dosferatu/electronic-compass/Documentation/Project Documentation/Weekly Status Reports/Cody/Cody Weekly Status Report 6.docx

Weekly Status Report

Electronic Compass Practicum Project

Team Member: Cody Gabriel

Week of 11/25/2013:

- Finished HW: Test Plan
- Created solder masks in EPL using laser cutter
- Bought backordered resistors from IEEE store on campus
- Unsuccessful search for needed physical switches
- Started presentation preparation outline

Next week:

- Continue search for switches; Surplus Gizmos?
- As parts come in, check them off the BOM
- Continuity check the boards
- Once all parts have come in, solder board together
