dosferatu/electronic-compass/Documentation/Project Documentation/Weekly Status Reports/Cody/Cody Weekly Status Report 7.docx

Weekly Status Report

Electronic Compass Practicum Project

Team Member: Cody Gabriel

Week of 12/2/2013:

- Found needed switches at Surplus Gizmos
- PMIC was not ordered; ordered with overnight shipping, arrived Friday
- Continuity check performed on all the boards
- One board was soldered together using reflow oven
- Discovered that μC needs preprogrammed to use USB

Next week:

- Program μC to use USB, then use USB to program
- Continue troubleshooting board
- Finish project presentation
- Continue revising documentation
- Present project on Fri, Dec. 13
