dosferatu/electronic-compass/Documentation/Project Documentation/Weekly Status Reports/Cody/Cody Weekly Status Report 4.docx

Weekly Status Report

Electronic Compass Practicum Project

Team Member: Cody Gabriel

Week of 11/11/2013:

- Finished write up for project schedule
- Revised and refined board layout with John
- Ensure board is ready to be sent to OSH Park, made changes advised by Andrew
- Fixed PMIC symbol with pins switched
- Added resistor to GPIO controlled switches
- Created system diagrams for System Design/Modeling, due 11/20/2013

For next week:

- Create BOM and order parts
- Finish System Design and Modeling due 11/20/2013
- Send board files to OSH Park by midnight 11/19/2013
- Look ahead to next week’s HW: Test Plan due 11/27/2013
- Find out what it takes to create a solder mask in EPL
