dosferatu/electronic-compass/Documentation/Project Documentation/Weekly Status Reports/Cody/Cody Weekly Status Report 5.docx

Weekly Status Report

Electronic Compass Practicum Project

Team Member: Cody Gabriel

Week of 11/18/2013:

- Created BOM and ordered parts
- Finished System Design and Modeling
- Sent board files to OSH Park on 11/19/2013
- Worked on this week’s HW: Test Plan due 11/27/2013

For next week:

- Finish HW: Test Plan
- Create solder masks in EPL using laser cutter
- Order switches and 2 resistor values in their respective quantities (backordered)
- Boards should be back soon, construct systems
- Proceed with testing and debugging
- Revise all documentation
- Start presentation preparation; Power Point, etc.
