dosferatu/electronic-compass/Documentation/Project Documentation/Weekly Status Reports/John/John Maseda Weekly Progress Report 11-12-2013.docx

Weekly Status Report

Electronic Compass Practicum Project

Team Member: John Maseda

Week of 11/12/2013:

1. Adopted changes to the schematic into new board layout.
2. Adjusted routing as necessary. (version 2)
3. Checked board layout with Andrew to make sure all was correct.
4. Adopted recommended changes to the schematic and rerouted the board.
5. Board layout and routing completed. (version 2.1)
