dosferatu/electronic-compass/Documentation/Project Documentation/Weekly Status Reports/John/John Maseda Weekly Progress Report 11-19-2013.docx

Weekly Status Report

Electronic Compass Practicum Project

Team Member: John Maseda

Week of 11/19/2013:

1. New information caused changes to sch.
2. Updated layout and routing – redid most of the board layout and routing. (Version 3.0)
3. Checked with Andrew before first deadline submission.
4. Updated sch, and layout with changes.
5. Sent in files to Andrew for final check.
6. Fixed critical errors listed updated layout and routing.
7. Sent files in to OSHpark for fabrication.
8. Purchased boards $19.85 for 4
9. Purchased boards at Andrews request at the same price.
