dosferatu/electronic-compass/Documentation/Project Documentation/Weekly Status Reports/Cody/Cody Weekly Status Report 3.docx

Weekly Status Report

Electronic Compass Practicum Project

Team Member: Cody Gabriel

Week of 11/4/2013:

- Revise schematic
- Make schematic checklist
- Fixed headers on schematic to reflect requirements of AVR
- Changed PMOS transistors to a much smaller version
- Added tests points to unused AVR pins and in the power supply
- Worked on project schedule, due on Wed., 11/13/2013
- Worked with John on board layout

For next week:

- Do write up for project schedule
- Revise and refine board layout with John
- Create BOM and order parts
- Ensure board is ready to be sent to OSH Park
- Look ahead to next HW: System Design/Modeling, due 11/20/2013
