dosferatu/electronic-compass/Documentation/Project Documentation/Weekly Status Reports/Ben/Weekly Status Report - 11 Nov.docx

Weekly Status Report

Electronic Compass Practicum Project

Team Member: Benjamin Huntsman

Week of 11/11/2013:

1. Started work on the image data structure to be used in the LCD
2. Worked on the schematic to make recommended changes from Andrew
3. Made updates to the board layout per schematic changes
4. Worked out LCD image algorithm for changing parts of the LCD instead of keeping a bunch of separate images.
