dosferatu/electronic-compass/Documentation/Project Documentation/Weekly Status Reports/Ben/Weekly Status Report - 4 Nov.docx

Weekly Status Report

Electronic Compass Practicum Project

Team Member: Benjamin Huntsman

Week of 11/4/2013:

1. Finished verification of SPI layout on board for the LCD.
2. Researched SPI programming
3. Uploaded necessary updates to group about pin layout for MCU and peripherals
4. Worked on algorithm for LCD screen mapping
