dosferatu/electronic-compass/Documentation/Project Documentation/Weekly Status Reports/John/John Maseda Weekly Progress Report 11-05-2013.docx

Weekly Status Report

Electronic Compass Practicum Project

Team Member: John Maseda

Week of 11/05/2013:

1. Completed board layout and routing.
