dosferatu/electronic-compass/Documentation/Project Documentation/Weekly Status Reports/Michael/WSR 11-09-13.docx

Weekly Status Report

Michael Walton

11/09/13

Looked in to using USB for serial communication for debugging and found it to be more work than simply placing LEDs where I am outputting highs from the 32U4, so I decided to just stick to working on the program itself. Communication with the LSM303 sensor has been established; I set an LED to light up when a data ready is read from bit 0 of the status register in the LSM303 magnetometer. TWI interface is finished, and the LSM303 interface is almost finished for reading the sensor.
