dosferatu/electronic-compass/Documentation/Project Documentation/Weekly Status Reports/Cody/Cody Weekly Status Report 2.docx

Weekly Status Report

Electronic Compass Practicum Project

Team Member: Cody Gabriel

Week of 10/28/2013:

- For USB charging, a PMIC was suggested by Andrew
- Investigated PMIC’s, selected LTC4067
- Footprint and symbol for LTC4067 made in Eagle
- Schematic Draft 1 completed with PMIC, error and warning free

For next week:

- Revise schematic
- Make schematic checklist
- Finalize schematic to include aesthetics
- Work on project schedule, due date TBD
- Work with John on board layout once schematic is finalized
