dosferatu/electronic-compass/Documentation/Project Documentation/Weekly Status Reports/John/John Maseda Weekly Progress Report 10-22-2013.docx

Weekly Status Report

Electronic Compass Practicum Project

Team Member: John Maseda

Week of 10/22/2013:

1. Downloaded and installed necessary software for designing our device.
  a. Eagle CAD
  b. GitHub
2. Began reading project specific documentation relevant to generating the schematic.
  a. Used Eagle CAD to get familiarity with building a very basic schematic.
