dosferatu/electronic-compass/Documentation/Project Documentation/Weekly Status Reports/John/John Maseda Weekly Progress Report 10-29-2013.docx

Weekly Status Report

Electronic Compass Practicum Project

Team Member: John Maseda

Week of 10/29/2013:

1. Down-loaded the schematic for the ATmega32u4 from GitHub.
  a. Studied the schematic – will need the pinouts relevant to headders and signal names to begin adding to the base footprint and schematic of the ATmega 32u4.
  b. Began formatting and adding Schematic related items to the schematic file.
2. Added some last minute schematic editions to the work Cody performed.
  a. Added connecting traces from MPC to headers.
  b. Angled some Vcc points up and some GND points down.
  c. Shifted some wires to attempt some clarity.
3. Created the board layout file
  a. Began rough placement of componants.
