dosferatu/electronic-compass/Documentation/Project Documentation/Weekly Status Reports/Ben/Weekly Status Report - 28 Oct.docx

Weekly Status Report

Electronic Compass Practicum Project

Team Member: Benjamin Huntsman

Week of 10/28/2013:

1. Pin layout for LCD submitted to the group
2. Researched the SPI interface and available drivers for the MCU.
3. Figured out an appropriate layout for the board stacking so that the sensor is isolated.
