dosferatu/electronic-compass/Schematics/OSH DRU/Board_Layout_Checklist.xlsx

Item | On-Board
On/Off Switch | check
Headers wired | check
Transistor switching LCD LED | check
Transistor switching LCD Vcc | check
No pull-ups for I2C because it is on the breakout | check
Serial Resistors on USB Data lines must be 22 Ohms +/- 5% | check
All USB lines should be as close to the same length as possible
Ucap should be 1uF +/- 10% | check
A 10uF cap should be on VBUS line | check
Connect SPI SS pin (PB0) to LCD Vcc as the on/off pin | check
All TWI lines should be as close to the same length as possible
Any generic I/O pin can be used for LCD back light | check | used PB6
External Oscilloscope
Note: Without an external clock, the USB will have to configured to operate in low-speed mode with the internal RC oscillator as input source clock for the PLL (p.256). Setup for this is on p. 260.
