dosferatu/electronic-compass/Documentation/Project Documentation/Requirements.xlsx

Marketing Requirements | Engineering Requirements | Justification
4 | 1. The system should be accurate to within 5° of true orientation. | To be a viable compass for use it should have an accepatable accuracy that would not result in an individual or robot being lost at long distances.
1,2,5 | 2. The system should have a switch to power on the device and within a short time be ready for use. | To save battery life, the user should be able to turn the device on and off. The reinitialization of the device should require as little time as possible so that the user can get their heading and proceed with very little lost time.
1 | 3. The LCD display will show a heading (i.e. "N", "SW") and degrees from North between 0 and 360 degrees. | Without an actual moving compass face, the user will need to easily understand the output of the device. Having eight segments it will be easy for the user to visualize their bearing.
3 | 4. Should be prepared for later versioning in firmware that will give additional options and restore to factory default through a USB interface. | If an unforeseen software glitch were to arise the device will still possibly be useful if restored to factory settings. The device should be capable of a software update to correct any unforeseen glitches.
6 | 5. LCD screen will have a back light so that the compass can be used in light or dark. | Needs to be used in varying conditions.
Marketing Requirements
1. Should be easy to use
2. Should be portable
3. Should be capable of being restored to factory default settings and capable of software updates.
4. Should be accurate enough so that an individual would not be lost at long distances.
5. Reset/Calibration Functionality
6. Can be used in day/night
Project Name: | Electronic Compass
Member Names: | Cody Gabriel
 | John Maseda
 | Michael Walton
 | Ben Huntsman
Date: | 2013-10-22
Version: | 1
Wiki URL: | http://goo.gl/bQ3hTW
