dosferatu/electronic-compass/Documentation/Project Documentation/Project Schedule.docx

Project Schedule

T05 – Handheld Electronic Compass

Ben Huntsman

Michael Walton

Cody Gabriel

John Maseda

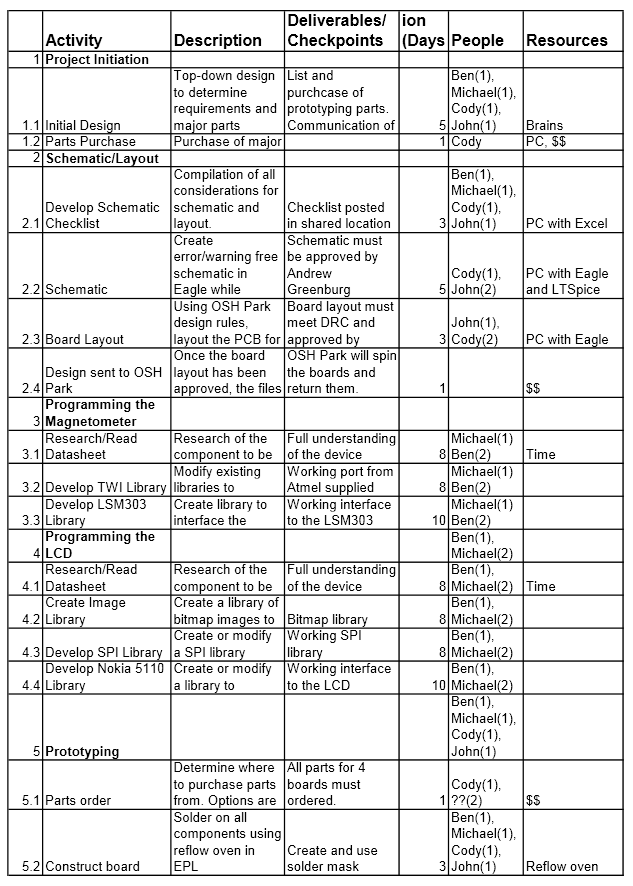
[picture p12: figure]
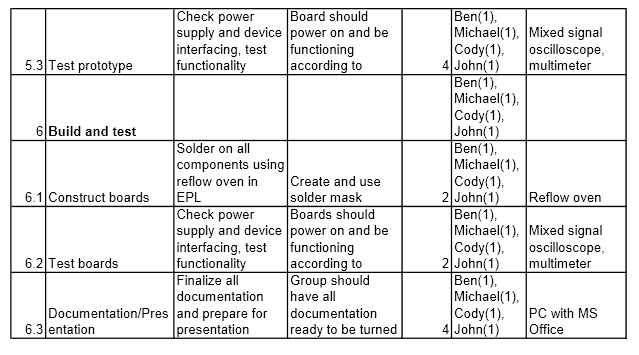
[picture p13: figure]
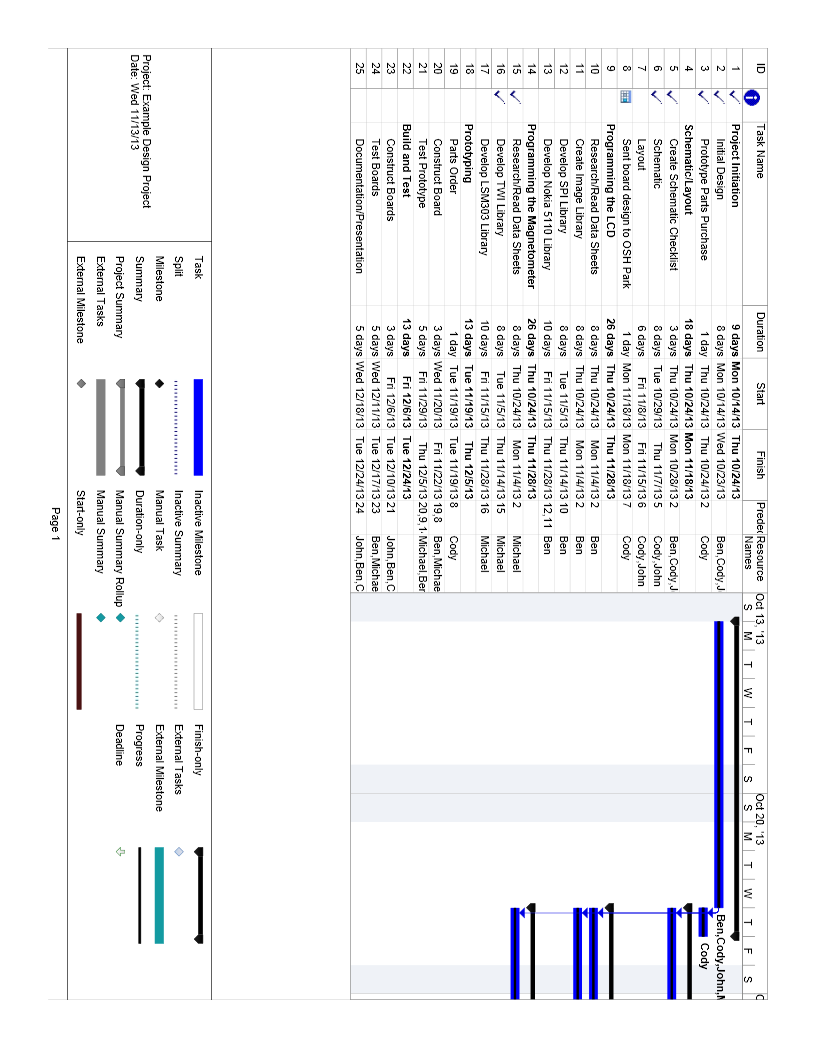
[picture p14: figure]
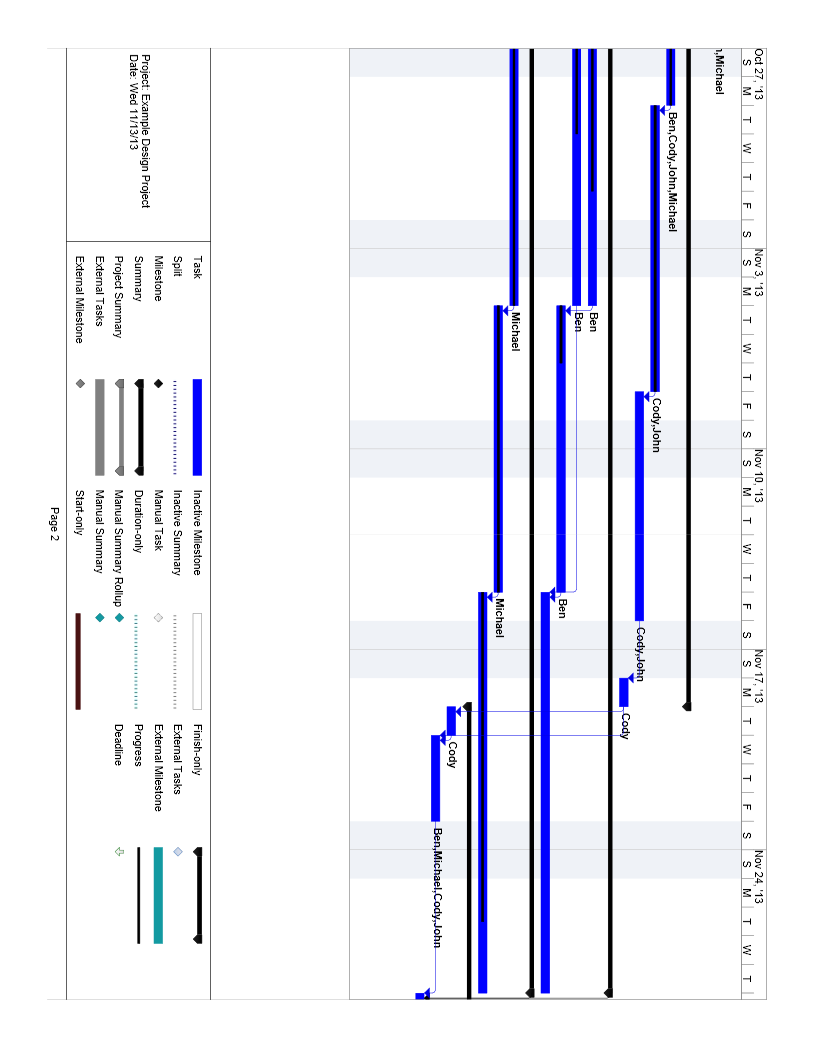
[picture p15: figure]
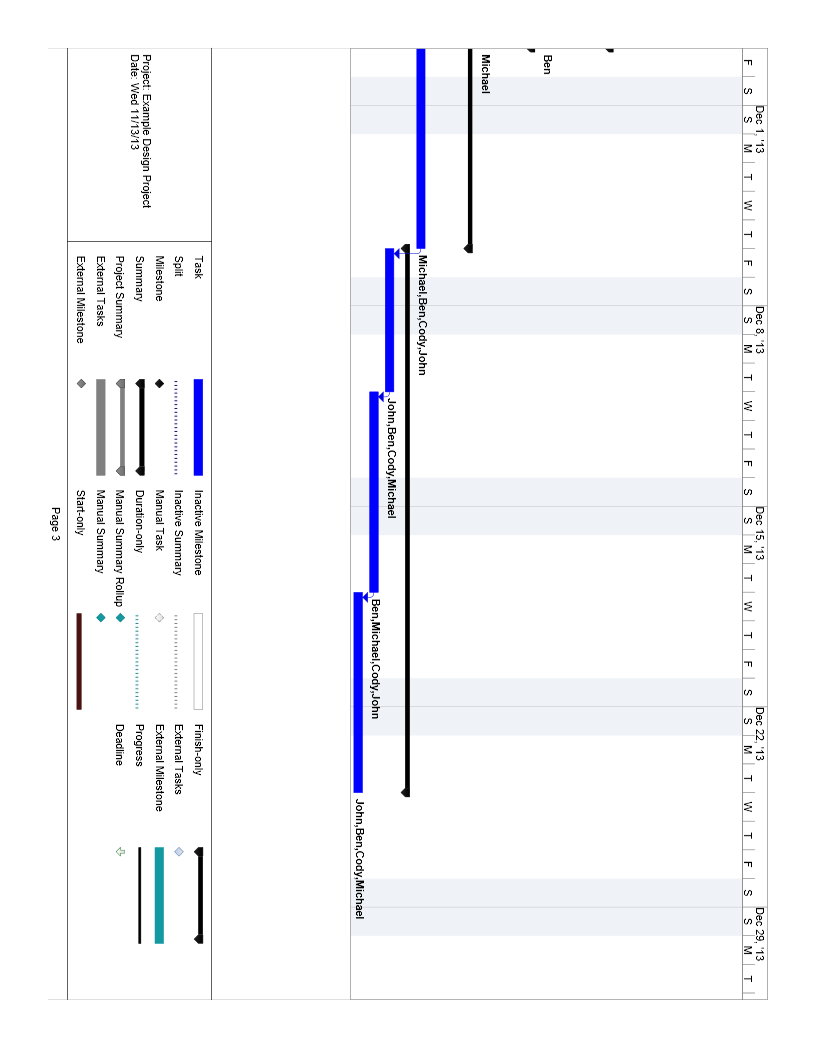
[picture p16: figure]
