dosferatu/electronic-compass/Documentation/Project Documentation/Work Breakdown Structure.xlsx

 | Activity | Description | Deliverables/Checkpoints | Duration (Days) | People | Resources | Predecessors
1 | Project Initiation
1.1 | Initial Design | Top-down design to determine requirements and major parts selection. | List and purchcase of prototyping parts. Communication of project goals | 5 | Ben(1), Michael(1), Cody(1), John(1) | Brains
1.2 | Parts Purchase | Purchase of major components. |  | 1 | Cody | PC, $$ | 1.1
2 | Schematic/Layout
2.1 | Develop Schematic Checklist | Compilation of all considerations for schematic and layout. | Checklist posted in shared location | 3 | Ben(1), Michael(1), Cody(1), John(1) | PC with Excel | 1.1
2.2 | Schematic | Create error/warning free schematic in Eagle while adhering to application notes for intercacing the major components. | Schematic must be approved by Andrew Greenburg | 5 | Cody(1), John(2) | PC with Eagle and LTSpice | 1.1
2.3 | Board Layout | Using OSH Park design rules, layout the PCB for the project based on the schematic. | Board layout must meet DRC and approved by Andrew Greenburg. | 3 | John(1), Cody(2) | PC with Eagle | 2.2
2.4 | Design sent to OSH Park | Once the board layout has been approved, the files will be sent to OSH Park. | OSH Park will spin the boards and return them. | 1 |  | $$ | 2.3
3 | Programming the Magnetometer
3.1 | Research/Read Datasheet | Research of the component to be able to proceed and program the device | Full understanding of the device operation | 8 | Michael(1) Ben(2) | Time | 1.2
3.2 | Develop TWI Library | Modify existing libraries to perform our specific requirements | Working port from Atmel supplied examples | 8 | Michael(1) Ben(2) |  | 3.1
3.3 | Develop LSM303 Library | Create library to interface the ATmega32u4 with the LSM303 | Working interface to the LSM303 | 10 | Michael(1) Ben(2) |  | 3.2
4 | Programming the LCD |  |  |  | Ben(1), Michael(2)
4.1 | Research/Read Datasheet | Research of the component to be able to proceed and program the device | Full understanding of the device operation | 8 | Ben(1), Michael(2) | Time | 1.2
4.2 | Create Image Library | Create a library of bitmap images to be displayed on the screen | Bitmap library | 8 | Ben(1), Michael(2) |  | 4.1
4.3 | Develop SPI Library | Create or modify a SPI library | Working SPI library | 8 | Ben(1), Michael(2) |  | 4.1
4.4 | Develop Nokia 5110 Library | Create or modify a library to interface the Atmega32u4 with the Nokia 5110 | Working interface to the LCD | 10 | Ben(1), Michael(2) |  | 4.3
5 | Prototyping |  |  |  | Ben(1), Michael(1), Cody(1), John(1) |  | 2.4, 3.2, 4.2
5.1 | Parts order | Determine where to purchase parts from. Options are online or in IEEE store on campus. | All parts for 4 boards must ordered. | 1 | Cody(1), ??(2) | $$ | 2.3
5.2 | Construct board | Solder on all components using reflow oven in EPL | Create and use solder mask | 3 | Ben(1), Michael(1), Cody(1), John(1) | Reflow oven | 2.4, 5.1
5.3 | Test prototype | Check power supply and device interfacing, test functionality | Board should power on and be functioning according to requirements. | 4 | Ben(1), Michael(1), Cody(1), John(1) | Mixed signal oscilloscope, multimeter | 5.2
6 | Build and test |  |  |  | Ben(1), Michael(1), Cody(1), John(1)
6.1 | Construct boards | Solder on all components using reflow oven in EPL | Create and use solder mask | 2 | Ben(1), Michael(1), Cody(1), John(1) | Reflow oven | 5.3
6.2 | Test boards | Check power supply and device interfacing, test functionality | Boards should power on and be functioning according to requirements. | 2 | Ben(1), Michael(1), Cody(1), John(1) | Mixed signal oscilloscope, multimeter | 6.1
6.3 | Documentation/Presentation | Finalize all documentation and prepare for presentation | Group should have all documentation ready to be turned in. Prep for presentation. | 4 | Ben(1), Michael(1), Cody(1), John(1) | PC with MS Office | 6.2
