dosferatu/electronic-compass/Documentation/ElectronicCompass_T05.pdf

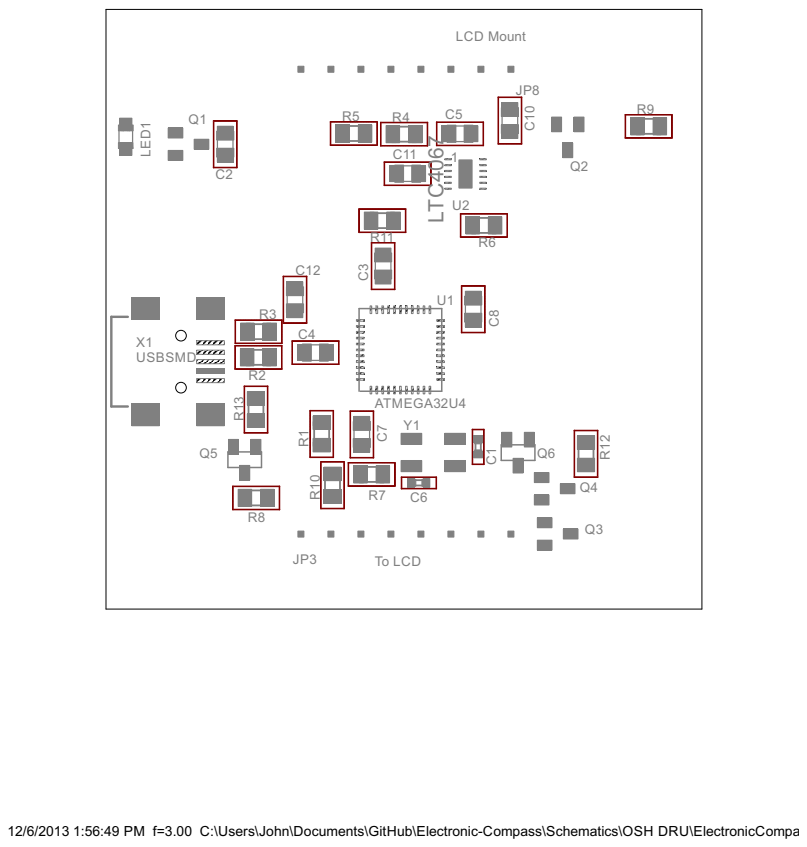
[picture p17: page 1]

12/6/2013 1:56:49 PM f=3.00 C:\Users\John\Documents\GitHub\Electronic-Compass\Schematics\OSH DRU\ElectronicCompass_T05.brd
