dosferatu/electronic-compass/Schematics/Breakout Boards/ATmega32U4 Breakout/32U4_Breakout-v11.pdf

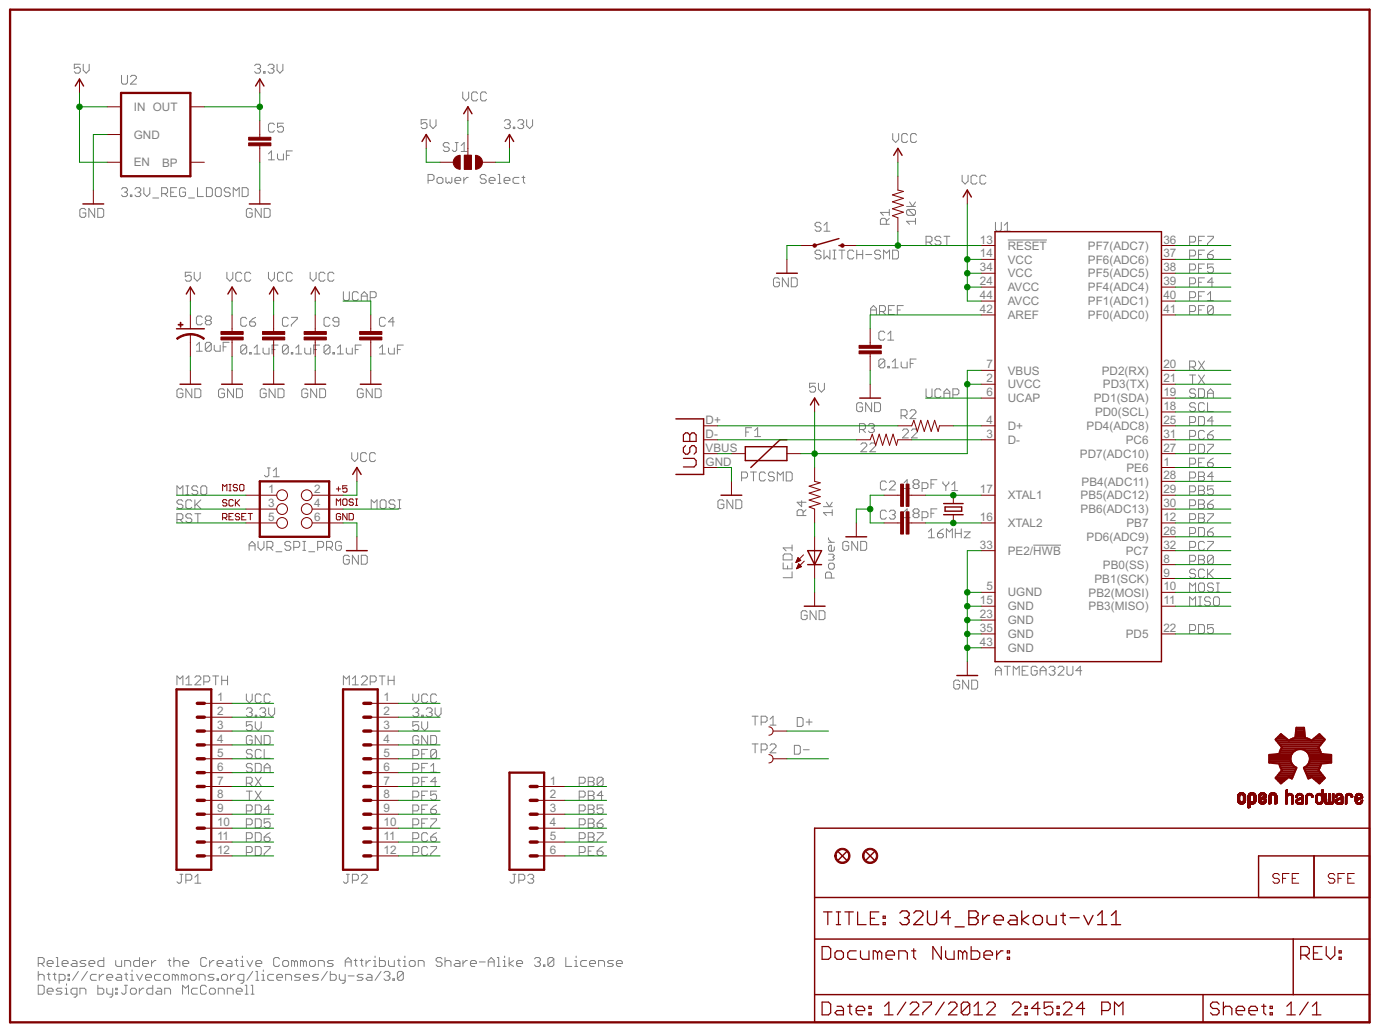
[picture p18: page 1]
