dosferatu/electronic-compass/Schematics/Breakout Boards/Magnetometer Breakout/LSM303 breakout board-v12.pdf

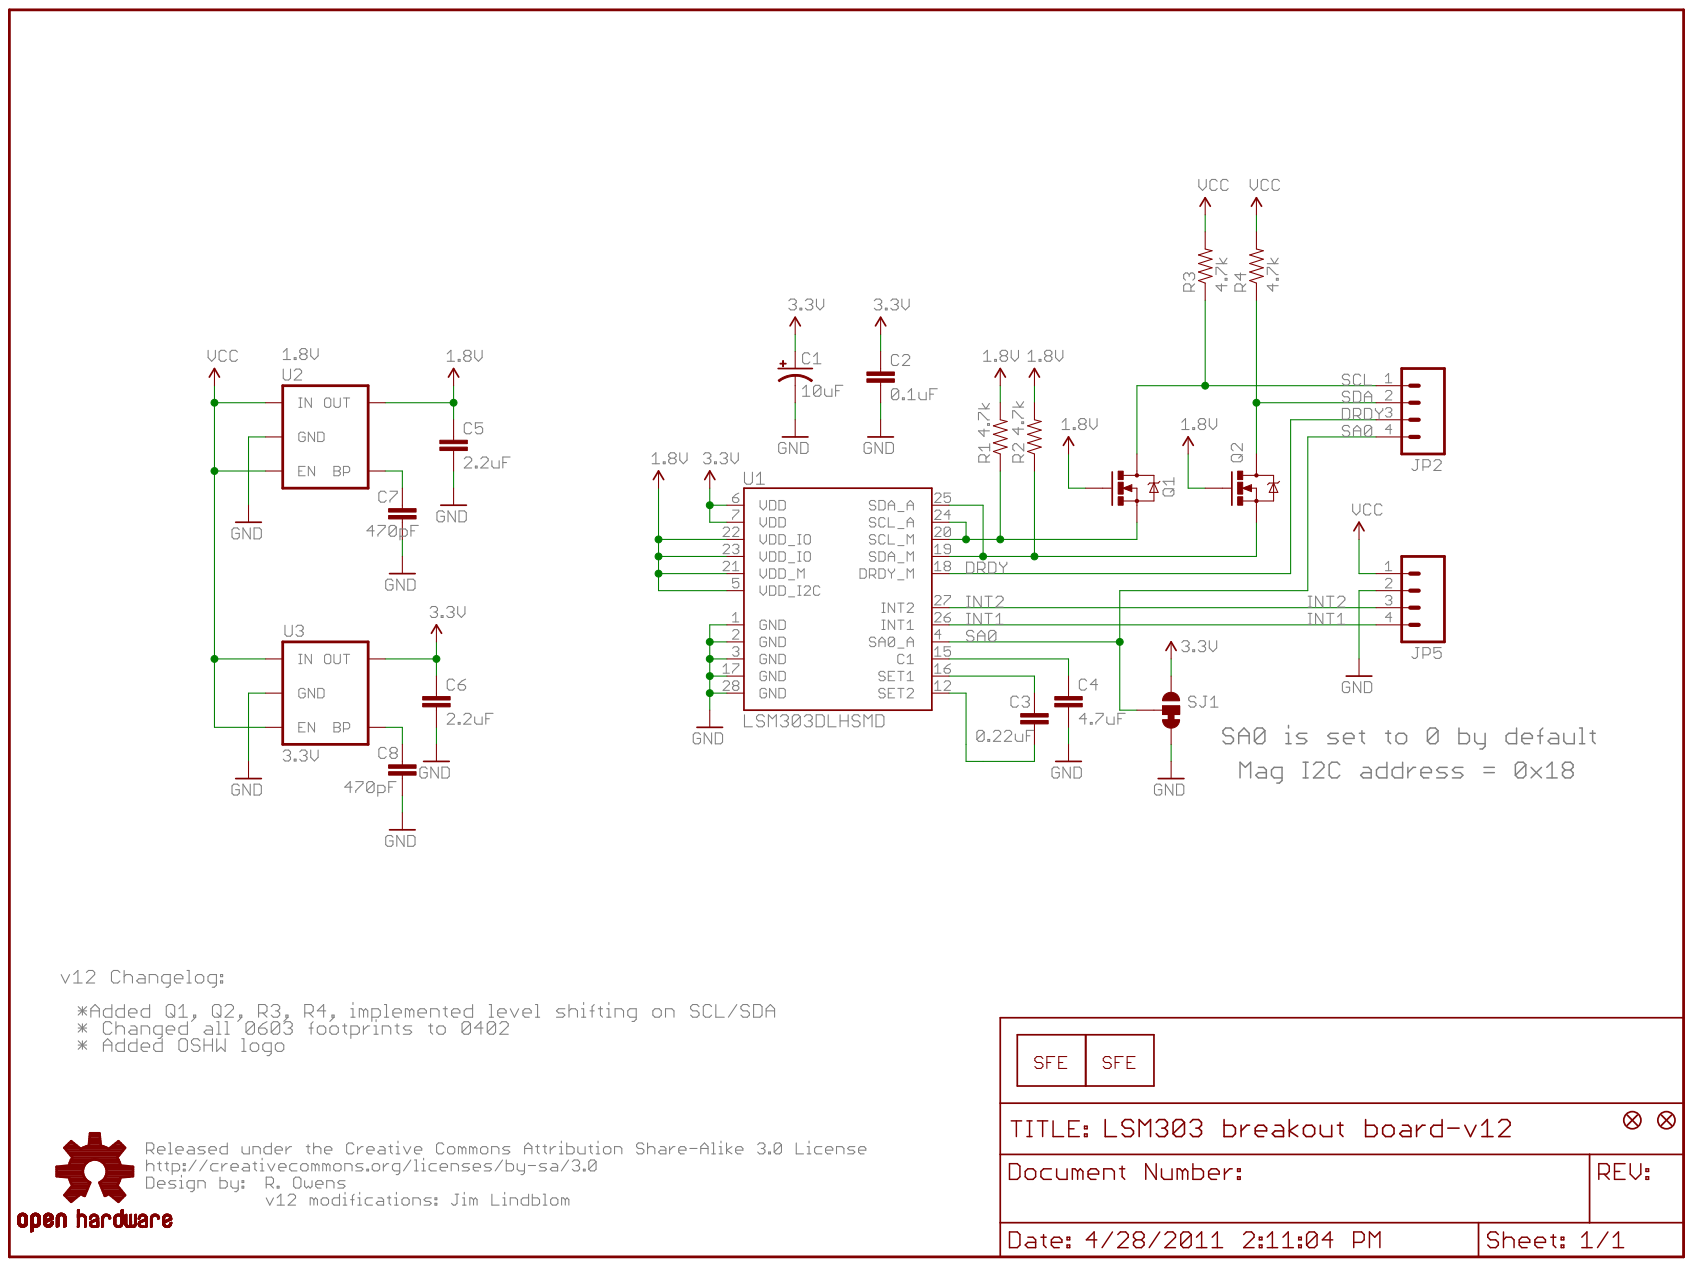
[picture p19: page 1]
