dosferatu/electronic-compass/Documentation/Battery/JST(2)-01548.pdf

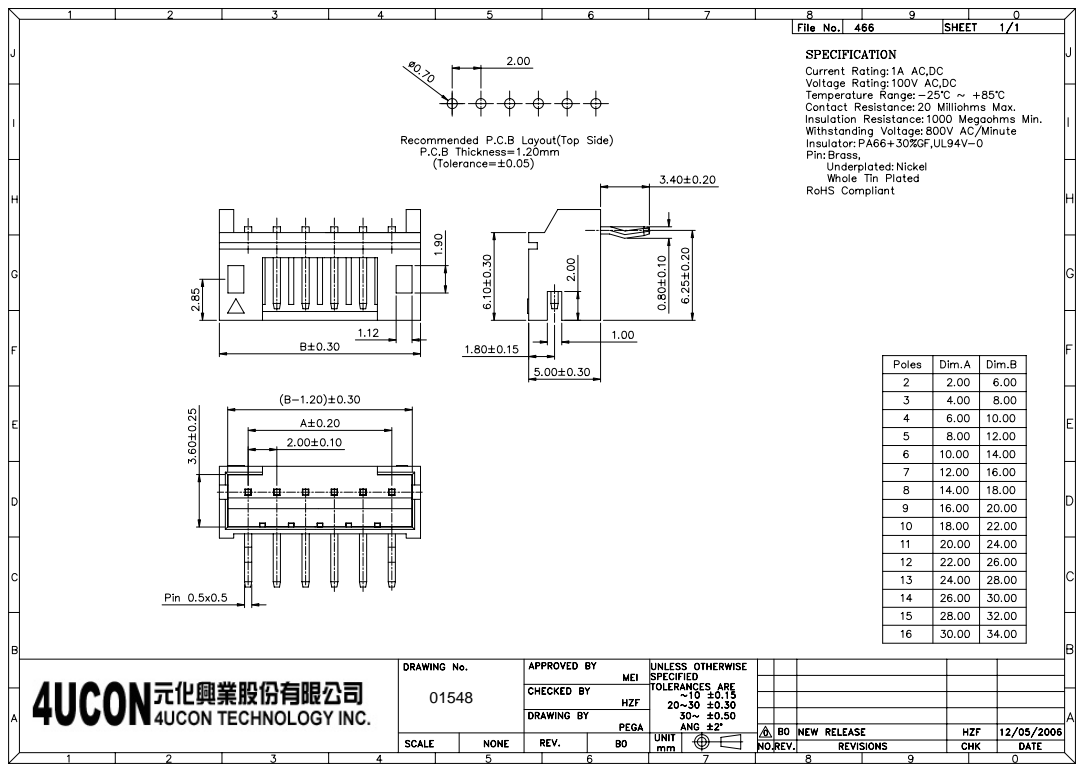
[picture p20: page 1]
