dosferatu/electronic-compass/Schematics/PMOS Switch/PMOS switch.asc

M1: pmos; FDS4435A
M2: pmos; FDS4435A
M3: pmos; FDS4435A
M4: pmos; FDS4435A
Q1: npn; 2N3904
Q2: npn; 2N3904
R1: res; 1MEG
R2: res; 1MEG
R3: res; 1k
R4: res; 10k
R5: res; 1k
R6: res; 1k
R7: res; 1MEG
R8: res; 1k
V1: voltage; PULSE(0 3.3 0 1f 1f 1 2)
V2: voltage; 3.3
V3: voltage; PULSE(0 3.3 0 1f 1f 1 2)
V4: voltage; 3.3
V5: voltage; PULSE(0 3.3 0 1f 1f 1 2)
V6: voltage; 3.3
V7: voltage; PULSE(0 3.3 0 1f 1f 1 2)
V8: voltage; 3.3
Named nets: 0, out, Vout, V
.tran 5
Here's the winner
