dosferatu/electronic-compass/Schematics/OSH DRU/ElectronicCompass_T05.brd

## EAGLE design Schematics/OSH DRU/ElectronicCompass_T05.brd (2014-11-09)

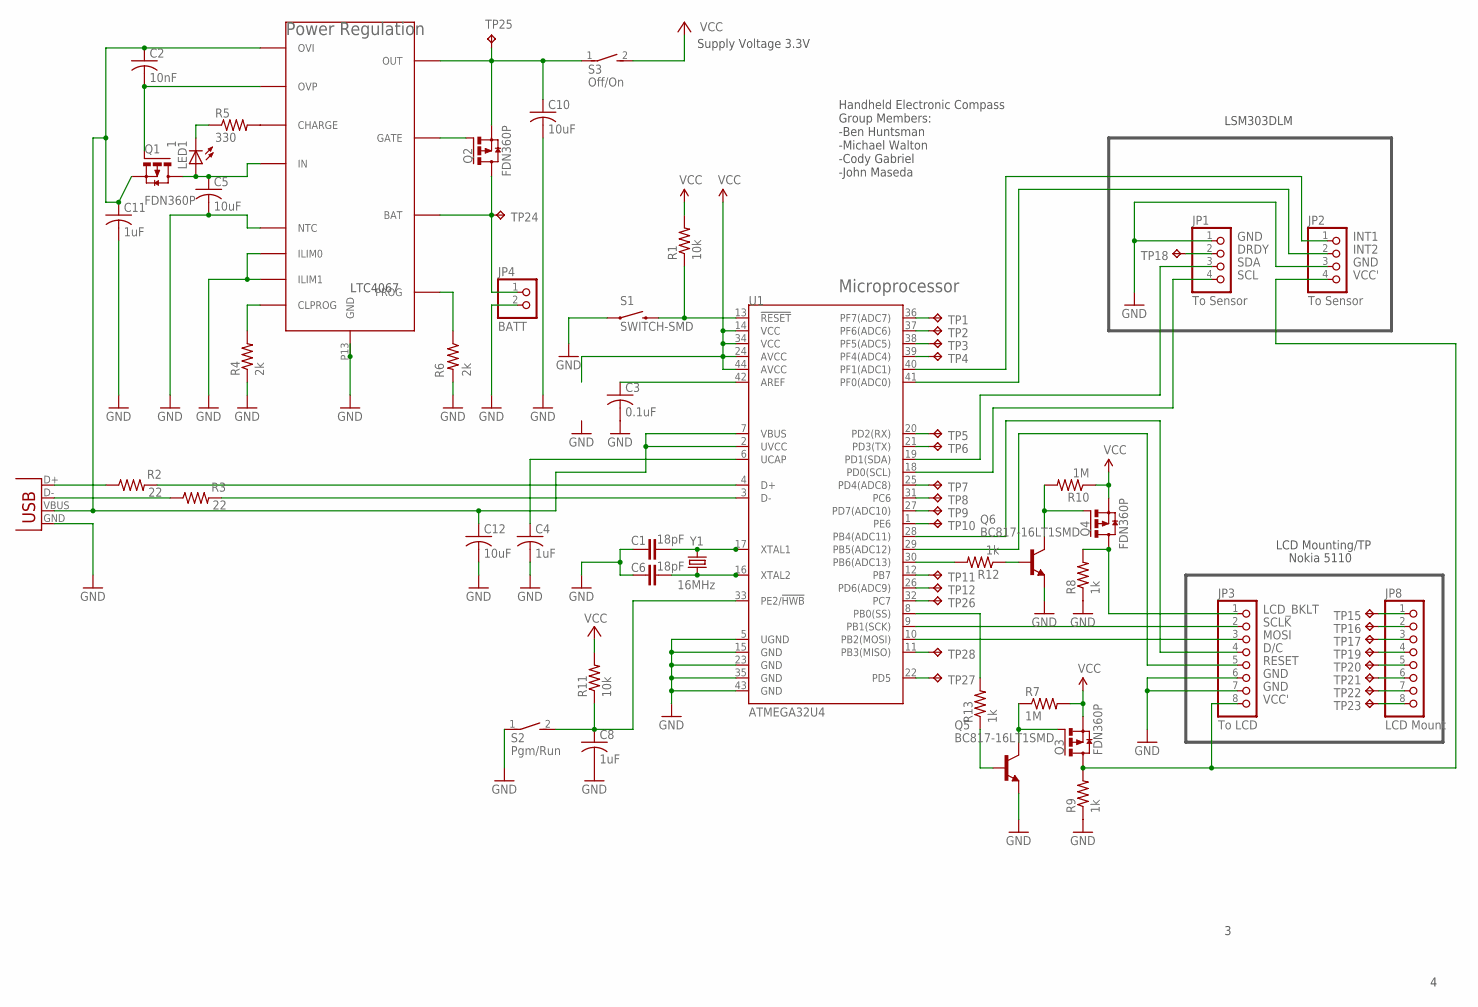
[picture p21: schematic ElectronicCompass_T05.sch]

Parts:
C1, C6: 18pF; 0402-CAP
C2: 10nF; C0805
C3: 0.1uF; C0805
C4, C8, C11: 1uF; C0805
C5, C10, C12: 10uF; C0805
JP1, JP2: To Sensor; 1X04
JP3: To LCD; 1X08
JP4: BATT; 1X02
JP8: LCD Mount; 1X08
LED1: 1; CHIPLED_0805
Q1, Q2, Q3, Q4: FDN360P; SUPER-SOT3
Q5, Q6: BC817-16LT1SMD; SOT23-BEC
R1, R11: 10k; M0805
R2, R3: 22; M0805
R4, R6: 2k; M0805
R5: 330; M0805
R7, R10: 1M; M0805
R8, R9, R12, R13: 1k; M0805
S1: SWITCH-SMD; TACTILE_SWITCH_SMD
S2: Pgm/Run; DS-01
S3: Off/On; DS-01
TP1, TP2, TP3, TP4, TP5, TP6, TP7, TP8, TP9, TP10, TP11, TP12, TP15, TP16, TP17, TP18, TP19, TP20, TP21, TP22, TP23, TP24, TP25, TP26, TP27, TP28: TPTP06R; TP06R
U1: ATMEGA32U4; QFN-44-NOPAD
U2: LTC4067; DFN-12
X1: USBSMD; USB-MINIB
Y1: 16MHz; CRYSTAL-SMD-5X3

Connections:
D-: R3.2, U1.3 (D-)
D/C: JP3.4, U1.28 (PB4(ADC11))
DRDY: JP1.2, TP18.TP
GND: C1.1, C3.2, C4.2, C5.2, C6.1, C8.2, C10.2, C11.2, C12.2, JP1.1, JP2.3, JP3.6, JP3.7, JP4.2, Q5.E, Q6.E, R4.1, R6.2, R8.1, R9.1, S1.1, S2.1, U1.5 (UGND), U1.15 (GND), U1.23 (GND), U1.35 (GND), U1.43 (GND), U2.P3 (NTC), U2.P4 (ILIM0), U2.P5 (ILIM1), U2.P13 (GND), X1.GND
INT1: JP2.1, U1.40 (PF1(ADC1))
INT2: JP2.2, U1.41 (PF0(ADC0))
LCD_BKLT: JP3.1, Q4.3 (D), R8.2
MOSI: JP3.3, U1.10 (PB2(MOSI))
unnamed: R6.1, U2.P8 (PROG)
unnamed: TP26.TP, U1.32 (PC7)
unnamed: TP12.TP, U1.26 (PD6(ADC9))
unnamed: R4.2, U2.P1 (CLPROG)
unnamed: JP4.1, Q2.3 (D), TP24.TP, U2.P10 (BAT)
unnamed: C5.1, LED1.A, Q1.3 (D), U2.P12 (IN)
unnamed: R5.2, U2.P2 (CHARGE)
unnamed: LED1.C, R5.1
unnamed: C2.2, Q1.1 (G), U2.P7 (OVP)
unnamed: JP8.8, TP23.TP
unnamed: C8.1, R11.1, S2.2, U1.33 (PE2/!HWB)
unnamed: R3.1, X1.D-
unnamed: R2.1, X1.D+
unnamed: TP1.TP, U1.36 (PF7(ADC7))
unnamed: TP2.TP, U1.37 (PF6(ADC6))
unnamed: R12.2, U1.30 (PB6(ADC13))
unnamed: TP3.TP, U1.38 (PF5(ADC5))
unnamed: TP4.TP, U1.39 (PF4(ADC4))
unnamed: TP5.TP, U1.20 (PD2(RX))
unnamed: TP6.TP, U1.21 (PD3(TX))
unnamed: TP7.TP, U1.25 (PD4(ADC8))
unnamed: TP8.TP, U1.31 (PC6)
unnamed: TP9.TP, U1.27 (PD7(ADC10))
unnamed: TP10.TP, U1.1 (PE6)
unnamed: TP11.TP, U1.12 (PB7)
unnamed: Q4.1 (G), Q6.C, R10.2
unnamed: JP8.7, TP22.TP
unnamed: JP8.6, TP21.TP
unnamed: JP8.5, TP20.TP
unnamed: JP8.4, TP19.TP
unnamed: JP8.3, TP17.TP
unnamed: JP8.2, TP16.TP
unnamed: R2.2, U1.4 (D+)
unnamed: JP8.1, TP15.TP
unnamed: C10.1, Q2.2 (S), S3.1, TP25.TP, U2.P11 (OUT)
unnamed: R13.2, U1.8 (PB0(SS))
unnamed: C3.1, U1.42 (AREF)
unnamed: TP27.TP, U1.22 (PD5)
unnamed: TP28.TP, U1.11 (PB3(MISO))
unnamed: C1.2, U1.17 (XTAL1), Y1.3 (2)
unnamed: C6.2, U1.16 (XTAL2), Y1.1
unnamed: Q6.B, R12.1
unnamed: Q3.1 (G), Q5.C, R7.1
unnamed: Q2.1 (G), U2.P9 (GATE)
unnamed: Q5.B, R13.1
RESET: JP3.5, U1.29 (PB5(ADC12))
RST: R1.1, S1.3 (2), U1.13 (!RESET)
SCL: JP1.4, U1.18 (PD0(SCL))
SCLK: JP3.2, U1.9 (PB1(SCK))
SDA: JP1.3, U1.19 (PD1(SDA))
UCAP: C4.1, U1.6 (UCAP)
VBUS: C2.1, C11.1, C12.1, Q1.2 (S), U1.2 (UVCC), U1.7 (VBUS), U2.P6 (OVI), X1.VBUS
VCC: Q3.2 (S), Q4.2 (S), R1.2, R7.2, R10.1, R11.2, S3.2, U1.14 (VCC), U1.24 (AVCC), U1.34 (VCC), U1.44 (AVCC)
VCC': JP2.4, JP3.8, Q3.3 (D), R9.2

Notes on the sheet:
Microprocessor
Power Regulation
Handheld Electronic Compass Group Members: -Ben Huntsman -Michael Walton -Cody Gabriel -John Maseda
LCD Mounting/TP
LTC4067
LSM303DLM
Nokia 5110
Supply Voltage 3.3V

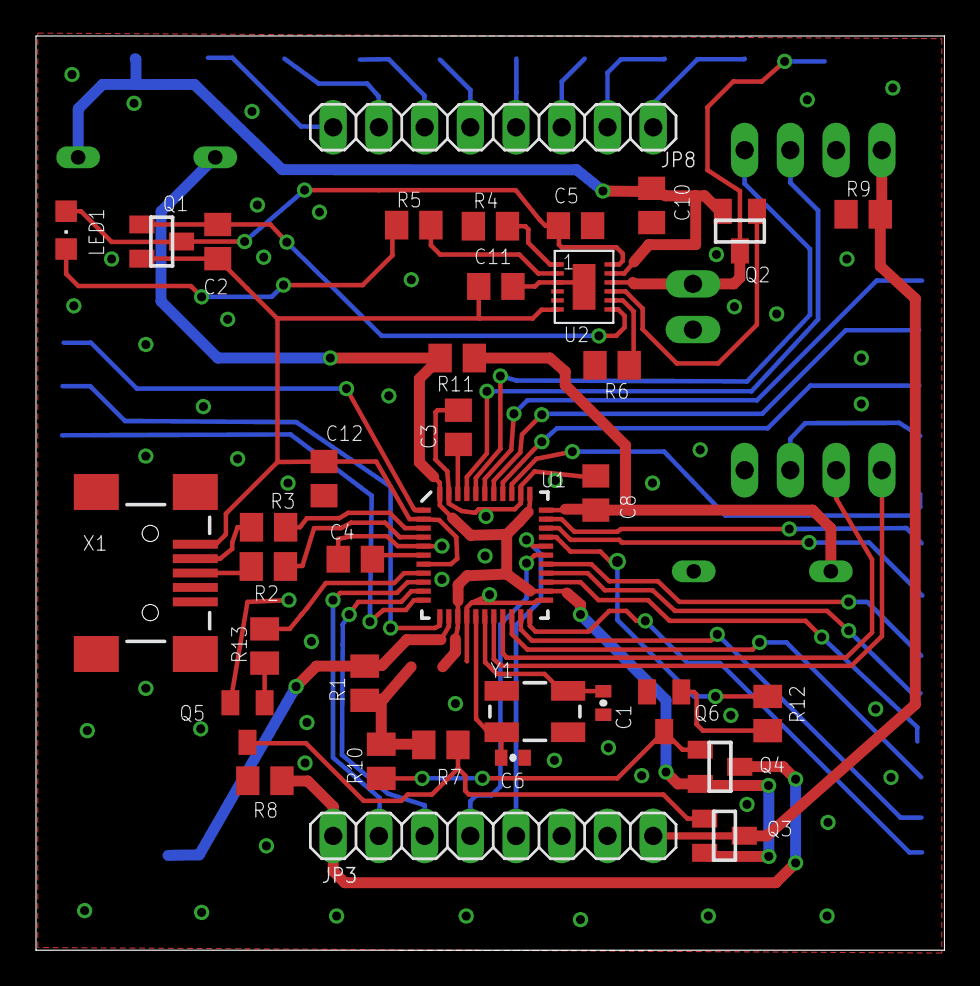
[picture p22: board ElectronicCompass_T05.brd from above]

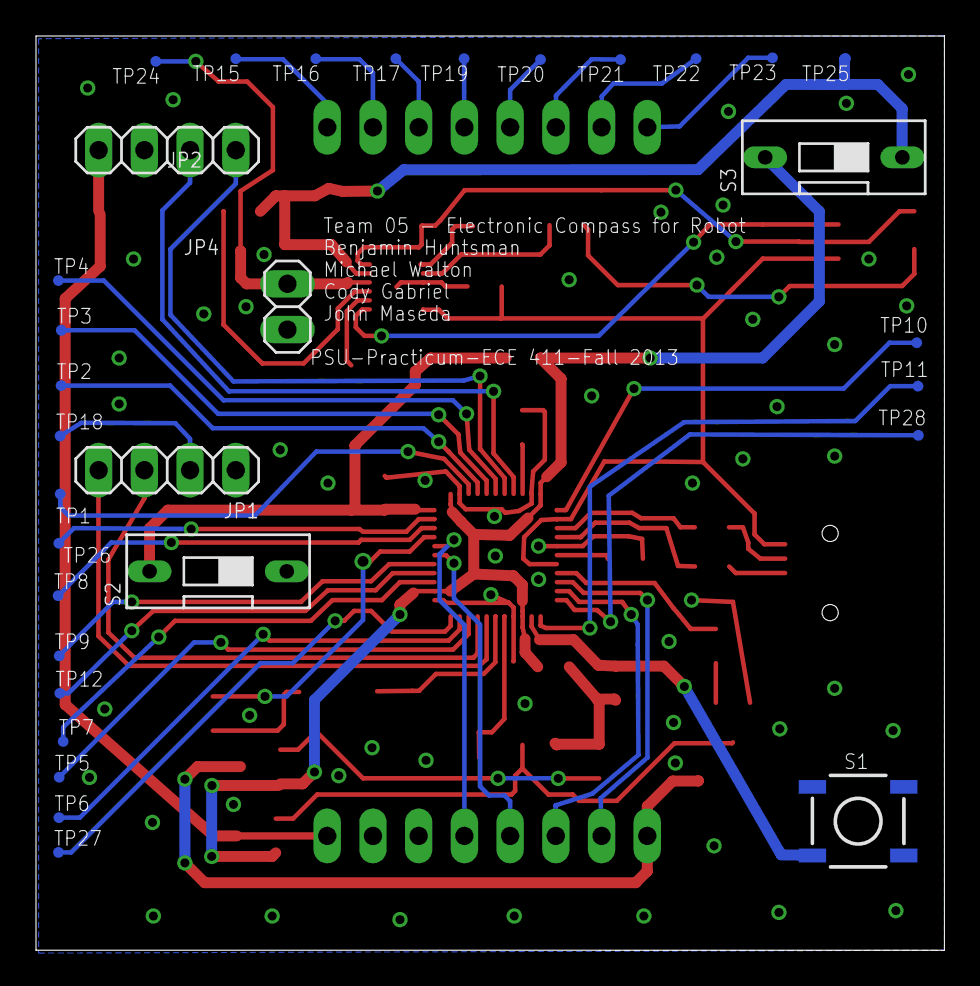
[picture p23: board ElectronicCompass_T05.brd from below]

Board: 2 copper layers, 50.5 x 50.8 mm, 68 parts (32 on the bottom side), 62 nets.
