dosferatu/electronic-compass/Schematics/Breakout Boards/ATmega32U4 Breakout/32U4_Breakout-v11.brd

## EAGLE design Schematics/Breakout Boards/ATmega32U4 Breakout/32U4_Breakout-v11.brd (2013-10-25)

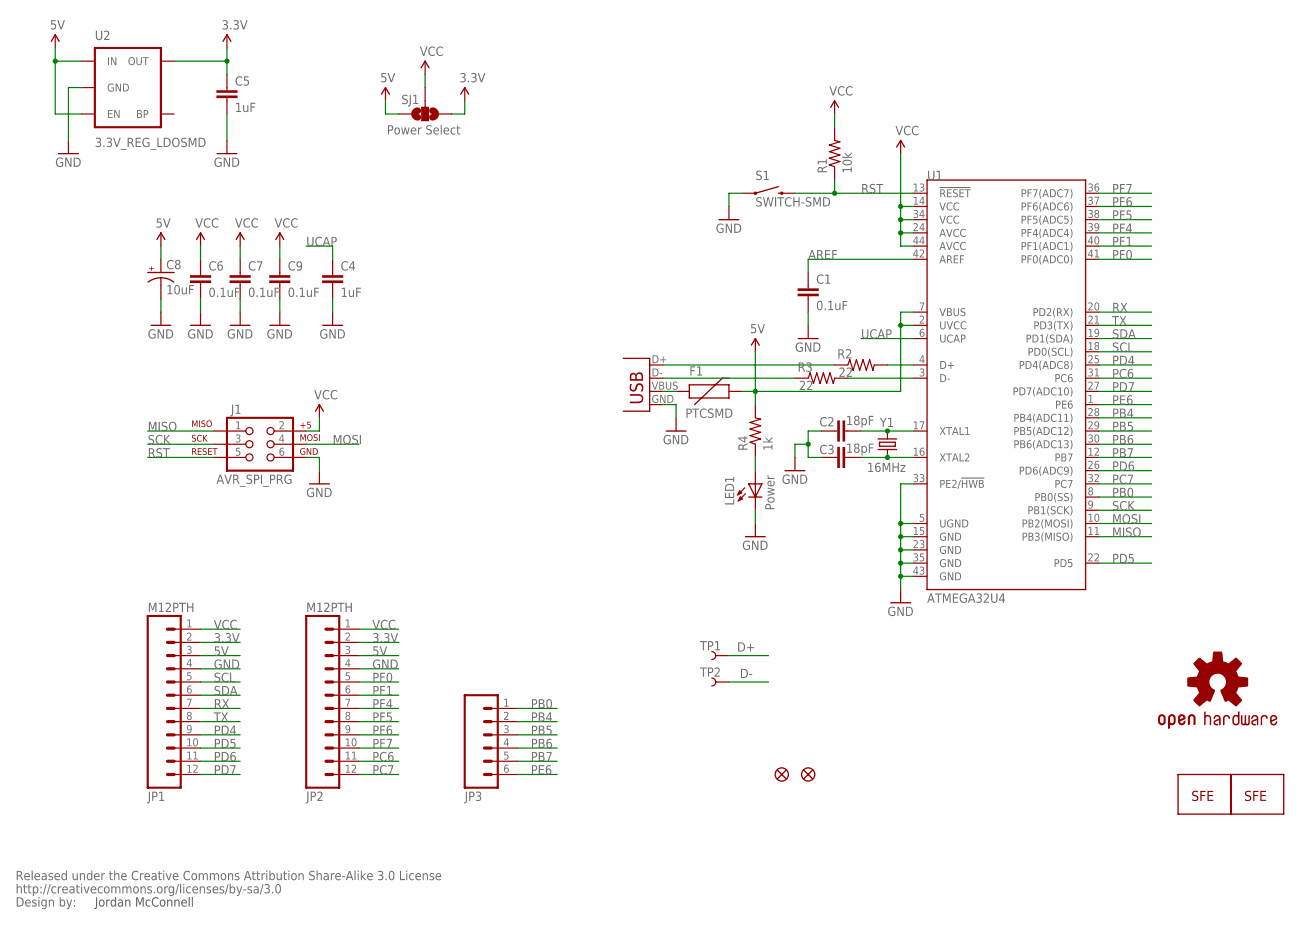
[picture p24: schematic 32U4_Breakout-v11.sch]

Parts:
C1, C6, C7, C9: 0.1uF; 0402-CAP
C2, C3: 18pF; 0402-CAP
C4, C5: 1uF; 0402-CAP
C8: 10uF; EIA3216
F1: PTCSMD; PTC-1206
J1: AVR_SPI_PRG; 2X3
JP1, JP2: M12PTH; 1X12
JP3: M06SIP; 1X06
JP4: LOGO-SFENEW; SFE-NEW-WEBLOGO
JP5: LOGO-SFESK; SFE-LOGO-FLAME
JP6, JP7: FIDUCIALUFIDUCIAL; MICRO-FIDUCIAL
LED1: Power; LED-0603
R1: 10k; 0402-RES
R2, R3: 22; 0402-RES
R4: 1k; 0402-RES
S1: SWITCH-SMD; TACTILE_SWITCH_SMD
SJ1: Power Select; SJ_3_PASTE2&3
TP1, TP2: TEST-POINT3; PAD.03X.03
U1: ATMEGA32U4; QFN-44-NOPAD
U2: 3.3V_REG_LDOSMD; SOT23-5
U$6: OSHW-LOGOM; OSHW-LOGO-M
U$7: CREATIVE_COMMONS
X1: USBSMD; USB-MINIB
Y1: 16MHz; CRYSTAL-SMD-5X3

Connections:
3.3V: C5.1, JP1.2, JP2.2, SJ1.1, U2.5 (OUT)
5V: C8.A (+), F1.2, JP1.3, JP2.3, R4.2, SJ1.3, U1.2 (UVCC), U1.7 (VBUS), U2.1 (IN), U2.3 (EN)
AREF: C1.1, U1.42 (AREF)
D+: R2.1, TP1.P$1, X1.D+
D-: R3.1, TP2.P$1, X1.D-
GND: C1.2, C2.1, C3.1, C4.2, C5.2, C6.2, C7.2, C8.C (-), C9.2, J1.6, JP1.4, JP2.4, LED1.C, S1.1, U1.5 (UGND), U1.15 (GND), U1.23 (GND), U1.33 (PE2/!HWB), U1.35 (GND), U1.43 (GND), U2.2 (GND), X1.GND
MISO: J1.1, U1.11 (PB3(MISO))
MOSI: J1.4, U1.10 (PB2(MOSI))
unnamed: C2.2, U1.17 (XTAL1), Y1.3 (2)
unnamed: C3.2, U1.16 (XTAL2), Y1.1
unnamed: F1.1, X1.VBUS
unnamed: R2.2, U1.4 (D+)
unnamed: R3.2, U1.3 (D-)
unnamed: LED1.A, R4.1
PB0: JP3.1, U1.8 (PB0(SS))
PB4: JP3.2, U1.28 (PB4(ADC11))
PB5: JP3.3, U1.29 (PB5(ADC12))
PB6: JP3.4, U1.30 (PB6(ADC13))
PB7: JP3.5, U1.12 (PB7)
PC6: JP2.11, U1.31 (PC6)
PC7: JP2.12, U1.32 (PC7)
PD4: JP1.9, U1.25 (PD4(ADC8))
PD5: JP1.10, U1.22 (PD5)
PD6: JP1.11, U1.26 (PD6(ADC9))
PD7: JP1.12, U1.27 (PD7(ADC10))
PE6: JP3.6, U1.1 (PE6)
PF0: JP2.5, U1.41 (PF0(ADC0))
PF1: JP2.6, U1.40 (PF1(ADC1))
PF4: JP2.7, U1.39 (PF4(ADC4))
PF5: JP2.8, U1.38 (PF5(ADC5))
PF6: JP2.9, U1.37 (PF6(ADC6))
PF7: JP2.10, U1.36 (PF7(ADC7))
RST: J1.5, R1.1, S1.3 (2), U1.13 (!RESET)
RX: JP1.7, U1.20 (PD2(RX))
SCK: J1.3, U1.9 (PB1(SCK))
SCL: JP1.5, U1.18 (PD0(SCL))
SDA: JP1.6, U1.19 (PD1(SDA))
TX: JP1.8, U1.21 (PD3(TX))
UCAP: C4.1, U1.6 (UCAP)
VCC: C6.1, C7.1, C9.1, J1.2, JP1.1, JP2.1, R1.2, SJ1.2, U1.14 (VCC), U1.24 (AVCC), U1.34 (VCC), U1.44 (AVCC)

Notes on the sheet:
Jordan McConnell

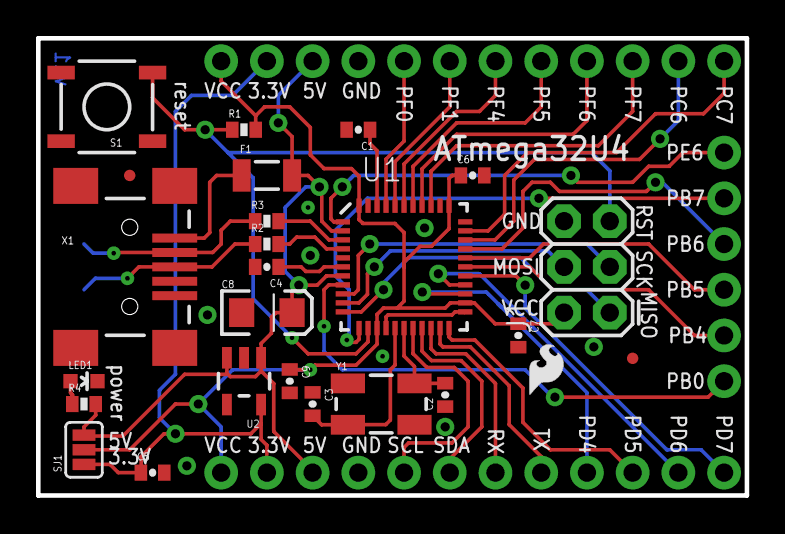
[picture p25: board 32U4_Breakout-v11.brd from above]

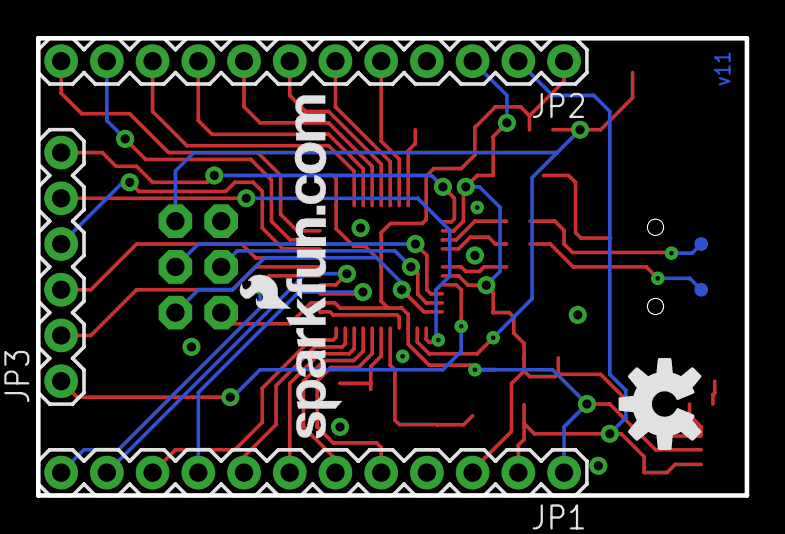
[picture p26: board 32U4_Breakout-v11.brd from below]

Board: 2 copper layers, 39.4 x 25.4 mm, 33 parts (7 on the bottom side), 40 nets.
