dosferatu/electronic-compass/src/PCD8544/PCD8544.cpp

#include <util/delay.h>
#include "PCD8544.h"
#include "image_parts.h"

using namespace std;

PCD8544::PCD8544()
{
}

PCD8544::~PCD8544()
{
}

// Function to clear the display
void PCD8544::ClearDisplay()
{
  // Write 0's to all 6 blocks in all 84 columns
  for (int i = 0; i < (LCD_WIDTH * 6); ++i)
    WriteColumn(0x00);

  return;
}

// Uses the given heading to update the UI accordingly
void PCD8544::DisplayHeading(const int headingValue)
{
  ClearDisplay();

  // Ensure the X address is reset
  SendCommand(0x80);

  // Ensure the Y address is reset
  SendCommand(0x40);

  UpdateLetters(headingValue);
  UpdateNumbers(headingValue);
  //DisplayImage(sample);

  return;
}

// Display an entire 48x84 bitmap image
void PCD8544::DisplayImage(const uint8_t image[][6])
{
  // Reset the X & Y address
  SendCommand(0x80);
  SendCommand(0x40);

  for (int i = 0; i < LCD_WIDTH; ++i)
    for(int j = 5; j > -1; --j)
      WriteColumn(image[i][j]);

  return;
}

// Initialize the display
void PCD8544::InitPCD8544()
{
  // Pulse reset low to reset internal registers
  DDRB = LCD_RST;
  PORTB = LCD_RST_LO;
  _delay_ms(100);
  PORTB = LCD_RST_HI;

  // Enable the Data/Command# output
  DDRB = LCD_DC;        

  // Initiate ATMega32U4 as a master on the SPI bus
  // Set MOSI and SCK output, all others input
  DDRB |= (1<<PB2)|(1<<PB1);

  // Enable SPI, Master, set clock rate fck/16 for 1MHz
  SPCR = (1<<SPE)|(1<<MSTR)|(1<<SPR0);

  //Set to active mode, vertical addressing, extended
  //instruction set.
  SendCommand(0x23);

  // Set Vop to (a + 16 * b)
  SendCommand(0x8E);

  // Set temp coefficient
  // Taken from SparkFun arduino sketch
  SendCommand(0x04);

  // LCD Bias
  SendCommand(0x14);

  // Set to normal instruction set
  SendCommand(0x22);

  // Set to normal display mode
  SendCommand(0x0C);

  // Set compass UI to default state
  ClearDisplay();

  return;
}

// Prints a digit given a number and a starting X address
void PCD8544::PrintDigit(const int number, const int startingColumn)
{
  switch(number)
  {
    case 0:

      for (int i = 0; i < 9; ++i)
      {
        // Increment X, reset Y addresses
        SendCommand(0x80 | (startingColumn + i));
        SendCommand(0x40 | UI_NUMBERS_Y);

        for (int j = 1; j > -1; --j)
          WriteColumn(zero[i][j]);
      }

      break;

    case 1:
      for (int i = 0; i < 9; ++i)
      {
        // Increment X, reset Y addresses
        SendCommand(0x80 | (startingColumn + i));
        SendCommand(0x40 | UI_NUMBERS_Y);

        for (int j = 1; j > -1; --j)
          WriteColumn(one[i][j]);
      }

      break;

    case 2:
      for (int i = 0; i < 9; ++i)
      {
        // Increment X, reset Y addresses
        SendCommand(0x80 | (startingColumn + i));
        SendCommand(0x40 | UI_NUMBERS_Y);

        for (int j = 1; j > -1; --j)
          WriteColumn(two[i][j]);
      }

      break;

    case 3:
      for (int i = 0; i < 9; ++i)
      {
        // Increment X, reset Y addresses
        SendCommand(0x80 | (startingColumn + i));
        SendCommand(0x40 | UI_NUMBERS_Y);

        for (int j = 1; j > -1; --j)
          WriteColumn(three[i][j]);
      }

      break;

    case 4:
      for (int i = 0; i < 9; ++i)
      {
        // Increment X, reset Y addresses
        SendCommand(0x80 | (startingColumn + i));
        SendCommand(0x40 | UI_NUMBERS_Y);

        for (int j = 1; j > -1; --j)
          WriteColumn(four[i][j]);
      }

      break;

    case 5:
      for (int i = 0; i < 9; ++i)
      {
        // Increment X, reset Y addresses
        SendCommand(0x80 | (startingColumn + i));
        SendCommand(0x40 | UI_NUMBERS_Y);

        for (int j = 1; j > -1; --j)
          WriteColumn(five[i][j]);
      }

      break;

    case 6:
      for (int i = 0; i < 9; ++i)
      {
        // Increment X, reset Y addresses
        SendCommand(0x80 | (startingColumn + i));
        SendCommand(0x40 | UI_NUMBERS_Y);

        for (int j = 1; j > -1; --j)
          WriteColumn(six[i][j]);
      }

      break;

    case 7:
      for (int i = 0; i < 9; ++i)
      {
        // Increment X, reset Y addresses
        SendCommand(0x80 | (startingColumn + i));
        SendCommand(0x40 | UI_NUMBERS_Y);

        for (int j = 1; j > -1; --j)
          WriteColumn(seven[i][j]);
      }

      break;

    case 8:
      for (int i = 0; i < 9; ++i)
      {
        // Increment X, reset Y addresses
        SendCommand(0x80 | (startingColumn + i));
        SendCommand(0x40 | UI_NUMBERS_Y);

        for (int j = 1; j > -1; --j)
          WriteColumn(eight[i][j]);
      }

      break;

    case 9:
      for (int i = 0; i < 9; ++i)
      {
        // Increment X, reset Y addresses
        SendCommand(0x80 | (startingColumn + i));
        SendCommand(0x40 | UI_NUMBERS_Y);

        for (int j = 1; j > -1; --j)
          WriteColumn(nine[i][j]);
      }

      break;

    default:
      break;
  }
  return;
}

// Send a command to the PCD8544
void PCD8544::SendCommand(const uint8_t command)
{
  PORTB = LCD_DC_LO;  // Set PCD8544 to command input

  // Start transmission
  SPDR = command;

  // Wait for transmission to complete
  while (!(SPSR & (1<<SPIF)));

  return;
}

// Update the letters indicating heading in the UI using a given bearing value
void PCD8544::UpdateLetters(const int headingValue)
{
  // Display North
  if ((headingValue >= 340 && headingValue < 360) || (headingValue > 0 && headingValue <= 20))
    for (int i = 0; i < 9; ++i)
    {
      // Increment X, reset Y addresses
      SendCommand(0x80 | (UI_LETTERS_X + i));
      SendCommand(0x40 | UI_LETTERS_Y);

      for (int j = 1; j > -1; --j)
        WriteColumn(N[i][j]);
    }

  // Display NorthEast
  else if(headingValue > 20 && headingValue < 70)
  {
    // The 'N'
    for (int i = 0; i < 9; ++i)
    {
      // Increment X, reset Y addresses
      SendCommand(0x80 | (UI_LETTERS_X + i));
      SendCommand(0x40 | UI_LETTERS_Y);

      for (int j = 1; j > -1; --j)
        WriteColumn(N[i][j]);
    }

    // The 'E'
    for (int i = 0; i < 9; ++i)
    {
      // Increment X, reset Y addresses
      SendCommand(0x80 | (UI_LETTERS_X + i + 10));
      SendCommand(0x40 | UI_LETTERS_Y);

      for (int j = 1; j > -1; --j)
        WriteColumn(E[i][j]);
    }
  }

  // Display East
  else if(headingValue >= 70 && headingValue <= 110)
    for (int i = 0; i < 9; ++i)
    {
      // Increment X, reset Y addresses
      SendCommand(0x80 | (UI_LETTERS_X + i));
      SendCommand(0x40 | UI_LETTERS_Y);

      for (int j = 1; j > -1; --j)
        WriteColumn(E[i][j]);
    }

  // Display SouthEast
  else if(headingValue > 110 && headingValue < 160)
  {
    // The 'S'
    for (int i = 0; i < 9; ++i)
    {
      // Increment X, reset Y addresses
      SendCommand(0x80 | (UI_LETTERS_X + i));
      SendCommand(0x40 | UI_LETTERS_Y);

      for (int j = 1; j > -1; --j)
        WriteColumn(S[i][j]);
    }

    // The 'E'
    for (int i = 0; i < 9; ++i)
    {
      // Increment X, reset Y addresses
      SendCommand(0x80 | (UI_LETTERS_X + i + 10));
      SendCommand(0x40 | UI_LETTERS_Y);

      for (int j = 1; j > -1; --j)
        WriteColumn(E[i][j]);
    }
  }

  // Display South
  else if(headingValue >= 160 && headingValue <= 200)
    for (int i = 0; i < 9; ++i)
    {
      // Increment X, reset Y addresses
      SendCommand(0x80 | (UI_LETTERS_X + i));
      SendCommand(0x40 | UI_LETTERS_Y);

      for (int j = 1; j > -1; --j)
        WriteColumn(S[i][j]);
    }

  // Display SouthWest
  else if(headingValue > 200 && headingValue < 250)
  {
    // The 'S'
    for (int i = 0; i < 9; ++i)
    {
      // Increment X, reset Y addresses
      SendCommand(0x80 | (UI_LETTERS_X + i));
      SendCommand(0x40 | UI_LETTERS_Y);

      for (int j = 1; j > -1; --j)
        WriteColumn(S[i][j]);
    }

    // The 'W'
    for (int i = 0; i < 9; ++i)
    {
      // Increment X, reset Y addresses
      SendCommand(0x80 | (UI_LETTERS_X + i + 10));
      SendCommand(0x40 | UI_LETTERS_Y);

      for (int j = 1; j > -1; --j)
        WriteColumn(W[i][j]);
    }
  }

  // Display West
  else if(headingValue >= 250 && headingValue <= 290)
    for (int i = 0; i < 9; ++i)
    {
      // Increment X, reset Y addresses
      SendCommand(0x80 | (UI_LETTERS_X + i));
      SendCommand(0x40 | UI_LETTERS_Y);

      for (int j = 1; j > -1; --j)
        WriteColumn(W[i][j]);
    }

  // Display NorthWest
  else if(headingValue > 290 && headingValue < 340)
  {
    // The 'N'
    for (int i = 0; i < 9; ++i)
    {
      // Increment X, reset Y addresses
      SendCommand(0x80 | (UI_LETTERS_X + i));
      SendCommand(0x40 | UI_LETTERS_Y);

      for (int j = 1; j > -1; --j)
        WriteColumn(N[i][j]);
    }

    // The 'W'
    for (int i = 0; i < 9; ++i)
    {
      // Increment X, reset Y addresses
      SendCommand(0x80 | (UI_LETTERS_X + i + 10));
      SendCommand(0x40 | UI_LETTERS_Y);

      for (int j = 1; j > -1; --j)
        WriteColumn(W[i][j]);
    }
  }

  return;
}

// Update the digits indicating heading in the UI using a given bearing value
void PCD8544::UpdateNumbers(const int headingValue)
{
  int hundreds = (headingValue / 100);
  int tens = ((headingValue - (hundreds * 100)) / 10);
  int ones = (headingValue % 10);

  // Print hundreds, tens, then ones.
  PrintDigit(hundreds, UI_NUMBERS_X);
  PrintDigit(tens, UI_NUMBERS_X + 10);
  PrintDigit(ones, UI_NUMBERS_X + 20);

  return;
}

// For vertical addressing in the PCD8544; write to a Y block
void PCD8544::WriteColumn(const uint8_t column)
{
  PORTB = LCD_DC_HI;  // Set PCD8544 to data input

  // Start transmission
  SPDR = column;

  // Wait for transmission to complete
  while (!(SPSR & (1<<SPIF)));

  return;
}

void PCD8544::BlinkDisplay(int count)
{
  for (int i = 0; i < count; ++i)
  {
    PORTB = LCD_BACKLIGHT_HI;
    _delay_ms(5);

    PORTB = LCD_BACKLIGHT_LO;
    _delay_ms(5);
  }
  _delay_ms(100);
  return;
}
