dosferatu/electronic-compass/src/LSM303DLH/LSM303DLH.h

/*
 * The ReadHeading() function uses the Pololu LSM303 Arduino library
 * as the design reference, and the license for that library has been
 * included as LICENSE.TXT. The ReadHeading() function uses
 * the heading() function implementation as a reference design, so
 * the included LICENSE.TXT file applies for this routine.
 */

#define TWI_START                  0x08  // START has been transmitted  
#define TWI_REP_START              0x10  // Repeated START has been transmitted
#define TWI_ARB_LOST               0x38  // Arbitration lost
#define TWI_TWBR                   0x0C  // Set the bit rate to 400KHz

/*
 * TWI Master Transmitter status codes
 */
#define TWI_MTX_ADR_ACK            0x18  // SLA+W has been tramsmitted and ACK received
#define TWI_MTX_ADR_NACK           0x20  // SLA+W has been tramsmitted and NACK received 
#define TWI_MTX_DATA_ACK           0x28  // Data byte has been tramsmitted and ACK received
#define TWI_MTX_DATA_NACK          0x30  // Data byte has been tramsmitted and NACK received 

/*
 * TWI Master Receiver status codes
 */
#define TWI_MRX_ADR_ACK            0x40  // SLA+R has been tramsmitted and ACK received
#define TWI_MRX_ADR_NACK           0x48  // SLA+R has been tramsmitted and NACK received
#define TWI_MRX_DATA_ACK           0x50  // Data byte has been received and ACK tramsmitted
#define TWI_MRX_DATA_NACK          0x58  // Data byte has been received and NACK tramsmitted

/*
 * TWI Slave Transmitter status codes
 */
#define TWI_STX_ADR_ACK            0xA8  // Own SLA+R has been received; ACK has been returned
#define TWI_STX_ADR_ACK_M_ARB_LOST 0xB0  // Arbitration lost in SLA+R/W as Master; own SLA+R has been received; ACK has been returned
#define TWI_STX_DATA_ACK           0xB8  // Data byte in TWDR has been transmitted; ACK has been received
#define TWI_STX_DATA_NACK          0xC0  // Data byte in TWDR has been transmitted; NOT ACK has been received
#define TWI_STX_DATA_ACK_LAST_BYTE 0xC8  // Last data byte in TWDR has been transmitted (TWEA = 0); ACK has been received

/*
 * TWI Slave Receiver status codes
 */
#define TWI_SRX_ADR_ACK            0x60  // Own SLA+W has been received ACK has been returned
#define TWI_SRX_ADR_ACK_M_ARB_LOST 0x68  // Arbitration lost in SLA+R/W as Master; own SLA+W has been received; ACK has been returned
#define TWI_SRX_GEN_ACK            0x70  // General call address has been received; ACK has been returned
#define TWI_SRX_GEN_ACK_M_ARB_LOST 0x78  // Arbitration lost in SLA+R/W as Master; General call address has been received; ACK has been returned
#define TWI_SRX_ADR_DATA_ACK       0x80  // Previously addressed with own SLA+W; data has been received; ACK has been returned
#define TWI_SRX_ADR_DATA_NACK      0x88  // Previously addressed with own SLA+W; data has been received; NOT ACK has been returned
#define TWI_SRX_GEN_DATA_ACK       0x90  // Previously addressed with general call; data has been received; ACK has been returned
#define TWI_SRX_GEN_DATA_NACK      0x98  // Previously addressed with general call; data has been received; NOT ACK has been returned
#define TWI_SRX_STOP_RESTART       0xA0  // A STOP condition or repeated START condition has been received while still addressed as Slave

/*
 * TWI Miscellaneous status codes
 */
#define TWI_NO_STATE               0xF8  // No relevant state information available; TWINT = 0
#define TWI_BUS_ERROR              0x00  // Bus error due to an illegal START or STOP condition
#define TWI_START                  0x08  // START has been transmitted  
#define TWI_REP_START              0x10  // Repeated START has been transmitted
#define TWI_ARB_LOST               0x38  // Arbitration lost

/*
 * TWI Master Transmitter status codes
 */
#define TWI_MTX_ADR_ACK            0x18  // SLA+W has been tramsmitted and ACK received
#define TWI_MTX_ADR_NACK           0x20  // SLA+W has been tramsmitted and NACK received 
#define TWI_MTX_DATA_ACK           0x28  // Data byte has been tramsmitted and ACK received
#define TWI_MTX_DATA_NACK          0x30  // Data byte has been tramsmitted and NACK received 

// TWI Master Receiver staus codes  
#define TWI_MRX_ADR_ACK            0x40  // SLA+R has been tramsmitted and ACK received
#define TWI_MRX_ADR_NACK           0x48  // SLA+R has been tramsmitted and NACK received
#define TWI_MRX_DATA_ACK           0x50  // Data byte has been received and ACK tramsmitted
#define TWI_MRX_DATA_NACK          0x58  // Data byte has been received and NACK tramsmitted

// TWI Slave Transmitter staus codes
#define TWI_STX_ADR_ACK            0xA8  // Own SLA+R has been received; ACK has been returned
#define TWI_STX_ADR_ACK_M_ARB_LOST 0xB0  // Arbitration lost in SLA+R/W as Master; own SLA+R has been received; ACK has been returned
#define TWI_STX_DATA_ACK           0xB8  // Data byte in TWDR has been transmitted; ACK has been received
#define TWI_STX_DATA_NACK          0xC0  // Data byte in TWDR has been transmitted; NOT ACK has been received
#define TWI_STX_DATA_ACK_LAST_BYTE 0xC8  // Last data byte in TWDR has been transmitted (TWEA = 0); ACK has been received

/*
 * TWI Slave Receiver status codes
 */
#define TWI_SRX_ADR_ACK            0x60  // Own SLA+W has been received ACK has been returned
#define TWI_SRX_ADR_ACK_M_ARB_LOST 0x68  // Arbitration lost in SLA+R/W as Master; own SLA+W has been received; ACK has been returned
#define TWI_SRX_GEN_ACK            0x70  // General call address has been received; ACK has been returned
#define TWI_SRX_GEN_ACK_M_ARB_LOST 0x78  // Arbitration lost in SLA+R/W as Master; General call address has been received; ACK has been returned
#define TWI_SRX_ADR_DATA_ACK       0x80  // Previously addressed with own SLA+W; data has been received; ACK has been returned
#define TWI_SRX_ADR_DATA_NACK      0x88  // Previously addressed with own SLA+W; data has been received; NOT ACK has been returned
#define TWI_SRX_GEN_DATA_ACK       0x90  // Previously addressed with general call; data has been received; ACK has been returned
#define TWI_SRX_GEN_DATA_NACK      0x98  // Previously addressed with general call; data has been received; NOT ACK has been returned
#define TWI_SRX_STOP_RESTART       0xA0  // A STOP condition or repeated START condition has been received while still addressed as Slave

/*
 * TWI Miscellaneous status codes
 */
#define TWI_NO_STATE               0xF8  // No relevant state information available; TWINT = 0
#define TWI_BUS_ERROR              0x00  // Bus error due to an illegal START or STOP condition

#ifndef LSM303_h
#define LSM303_h

/*
 * LSM303 defines
 */

// LSM303 device addresses
#define LSM303_ACCEL_READ_ADDRESS	0x31
#define LSM303_ACCEL_WRITE_ADDRESS	0x30
#define LSM303_MAG_READ_ADDRESS		0x3D
#define LSM303_MAG_WRITE_ADDRESS	0x3C

// LSM303 control/status regs
#define LSM303_CTRL_REG1_A       0x20
#define LSM303_CTRL_REG2_A       0x21
#define LSM303_CTRL_REG3_A       0x22
#define LSM303_CTRL_REG4_A       0x23
#define LSM303_CTRL_REG5_A       0x24
#define LSM303_HP_FILTER_RESET_A 0x25
#define LSM303_REFERENCE_A       0x26
#define LSM303_STATUS_REG_A      0x27

// LSM303 accel output regs
#define LSM303_OUT_X_L_A         0x28
#define LSM303_OUT_X_H_A         0x29
#define LSM303_OUT_Y_L_A         0x2A
#define LSM303_OUT_Y_H_A         0x2B
#define LSM303_OUT_Z_L_A         0x2C
#define LSM303_OUT_Z_H_A         0x2D

// LSM303 accel interrupt regs
#define LSM303_INT1_CFG_A        0x30
#define LSM303_INT1_SRC_A        0x31
#define LSM303_INT1_THS_A        0x32
#define LSM303_INT1_DURATION_A   0x33
#define LSM303_INT2_CFG_A        0x34
#define LSM303_INT2_SRC_A        0x35
#define LSM303_INT2_THS_A        0x36
#define LSM303_INT2_DURATION_A   0x37

#define LSM303_CRA_REG_M         0x00
#define LSM303_CRB_REG_M         0x01
#define LSM303_MR_REG_M          0x02

// LSM303 mag output regs
/* 
 * Starting a read will cause the LSM303 to increment the internal
 * sub address pointer automatically, so we just need the first regs
 */
#define LSM303_OUT_X_H_M         0x03
#define LSM303_OUT_X_L_M         0x04

// LSM303 status and ID regs
#define LSM303_SR_REG_M          0x09
#define LSM303_IRA_REG_M         0x0A
#define LSM303_IRB_REG_M         0x0B
#define LSM303_IRC_REG_M         0x0C
#define LSM303_WHO_AM_I_M        0x0F

// LSM303 mag output regs
#define LSM303_OUT_Y_H_M      0x05
#define LSM303_OUT_Y_L_M      0x06
#define LSM303_OUT_Z_H_M      0x07
#define LSM303_OUT_Z_L_M      0x08

// Calibration values
// This was done using the Pololu Arduino sketch
// that produces the calibration values to use.
#define cal_x_min	137
#define cal_y_min	-280
#define cal_z_min	-687
#define cal_x_max	793
#define cal_y_max	96
#define cal_z_max	381

// Vector to store coordinates
struct vector
{
  float x, y, z;
};

class LSM303DLH
{
  public:

    LSM303DLH();
    ~LSM303DLH();

    // LSM303DLH methods
    void InitLSM303DLH();
    int ReadHeading();
    
  private:
    // Vector calculations used in the ReadHeading() function
    float VectorDot(const vector*, const vector*);
    void VectorCross(const vector*, const vector*, vector*);
    void VectorNormalize(vector*);
    void BlinkLED(int);
};
#endif
