dosferatu/electronic-compass/src/PCD8544/image_parts.h

#include <inttypes.h>

/*
 * This header contains UI elements for the electronic compass.
 * Arrays containing the heading letters, numbers 0-9, and the
 * default compass UI are here.
 */

 // Letters for the UI
static const uint8_t N [][2] =
{
  {0xFF, 0xFF},
  {0x00, 0x0C},
  {0x00, 0x30},
  {0x00, 0xC0},
  {0x03, 0x00},
  {0x0C, 0x00},
  {0x30, 0x00},
  {0xC0, 0x00},
  {0xFF, 0xFF}
};

static const uint8_t E [][2] =
{
  {0xFF, 0xFF},
  {0x81, 0x01},
  {0x81, 0x01},
  {0x81, 0x01},
  {0x81, 0x01},
  {0x81, 0x01},
  {0x81, 0x01},
  {0x81, 0x01},
  {0x81, 0x01}
};

static const uint8_t S [][2] =
{
  {0x78, 0x7E},
  {0x80, 0x81},
  {0x80, 0x81},
  {0x80, 0x81},
  {0x80, 0x81},
  {0x80, 0x81},
  {0x80, 0x81},
  {0x80, 0x81},
  {0xFE, 0x0E}
};


static const uint8_t W [][2] =
{
  {0x03, 0xFF},
  {0x3C, 0x00},
  {0xC0, 0x00},
  {0x30, 0x00},
  {0x0F, 0xF0},
  {0x30, 0x00},
  {0xC0, 0x00},
  {0x3C, 0x00},
  {0x03, 0xFF}
};

// Digits 0-9 for the compass UI
static const uint8_t zero[][2] =
{
  {0x1F, 0xF8},
  {0x20, 0x04},
  {0x40, 0x02},
  {0x80, 0x01},
  {0x80, 0x01},
  {0x80, 0x01},
  {0x40, 0x02},
  {0x20, 0x04},
  {0x1F, 0xF8}
};

static const uint8_t one[][2] =
{
  {0x00, 0x00},
  {0x00, 0x00},
  {0x00, 0x00},
  {0x80, 0x0E},
  {0xFF, 0xFF},
  {0x80, 0x00},
  {0x00, 0x00},
  {0x00, 0x00},
  {0x00, 0x00}
};

static const uint8_t two[][2] =
{
  {0xFE, 0x18},
  {0x83, 0x04},
  {0x81, 0x02},
  {0x81, 0x01},
  {0x80, 0x81},
  {0x80, 0x81},
  {0x80, 0x42},
  {0x80, 0x44},
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
  {0x00, 0x00, 0x00, 0xFF, 0xFF, 0xFF},
  {0x00, 0x00, 0x00, 0xFF, 0xFF, 0xFF},
  {0x00, 0x00, 0x00, 0xFF, 0xFF, 0xFF},
  {0x00, 0x00, 0xFF, 0xFF, 0xFF, 0xFF},
  {0x00, 0x00, 0xFF, 0xFF, 0xFF, 0xFF},
  {0x00, 0x00, 0xFF, 0xFF, 0xFF, 0xFF},
  {0x00, 0x00, 0xFF, 0xFF, 0xFF, 0xFF},
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
};
