dosferatu/electronic-compass/(commit log)

2013-10-24 Loaded Requirements doc to repo
    [Requirements.xlsx]
2013-10-24 power management for USB charging using 32u4
2013-10-24 Loaded ATmega32U4 schematic; To use put it in your EAGLE CAD lbr folder. You won't find it under Atmel but instead under mega32u4 in your library when you search for it.
2013-10-24 Initial Schematic: only includes the ATmega32u4 on it
    [Initial.sch]
2013-10-24 Uploaded a bunch of documents that will help with the schematic and/or coding of the ATmega32u4
2013-10-25 Made changes to the file/folder structure and added some more supporting documentation.
    [32U4_Breakout-v11.brd, 32U4_Breakout-v11.sch, LSM303 breakout board-v12.brd, LSM303 breakout board-v12.sch, Requirements.xlsx]
2013-10-28 Version 1 Schematic
2013-10-31 Changed package types for passives
    [Initial.sch]
2013-11-01 Start integrating Atmel supplied TWI driver in to project.
2013-11-01 Modified main to include an interrupt enable.
2013-11-03 Schematic w/PMIC
    [Initial.sch]
2013-11-04 Schematic 1st draft
    [ElectronicCompass_T05.sch]
2013-11-04 Symbol and footprint for LTC4067 PMIC
2013-11-04 updated schematic - added some traces
2013-11-04 Changed unused GPIO's to test points
    [ElectronicCompass_T05.sch]
2013-11-04 Schematic - rotated some GND and Vcc to dwn and up
    [ElectronicCompass_T05.sch]
2013-11-04 Board Layout- Began (very rough) laying parts
    [ElectronicCompass_T05.brd]
2013-11-07 PMOS switch modeled in LTSpice
2013-11-07 Made it prettier...
    [ElectronicCompass_T05.sch]
2013-11-07 Added ON/OFF switch
    [ElectronicCompass_T05.brd, ElectronicCompass_T05.sch]
2013-11-09 The schematic has been finalized!
    [ElectronicCompass_T05.sch]
2013-11-10 Updated schematic/board layout check list. Submitted WPR for week of 11/5/13.
    [Board_Layout_Checklist.xlsx]
2013-11-10 Last minute changes to schematic before the layout begins
    [Board_Layout_Checklist.xlsx, ElectronicCompass_T05.brd, ElectronicCompass_T05.sch]
2013-11-11 Board layout changes
    [ElectronicCompass_T05.brd]
2013-11-11 Fixed the glcd library included in the project.
    [PCD8544.h]
2013-11-11 board layout continued
    [ElectronicCompass_T05.brd, ElectronicCompass_T05.sch]
2013-11-11 made some updates to the layout checklist
    [Board_Layout_Checklist.xlsx]
2013-11-11 New transistors
    [ElectronicCompass_T05.brd, ElectronicCompass_T05.sch]
2013-11-11 xtal added
    [ElectronicCompass_T05.brd, ElectronicCompass_T05.sch]
2013-11-11 gpio change push
    [ElectronicCompass_T05.brd, ElectronicCompass_T05.sch]
2013-11-12 WBS and Schedule updated
    [Work Breakdown Structure.xlsx]
2013-11-12 board layout complete
    [ElectronicCompass_T05.brd]
2013-11-12 push xtal move
    [ElectronicCompass_T05.brd]
2013-11-12 Grounded current limiting programming pins on PMIC
    [ElectronicCompass_T05.brd, ElectronicCompass_T05.sch]
2013-11-14 Made some changes to the schematic recommended by Andrew. It is not finished yet but there are some major changes that need to be done before we turn this thing in.
    [ElectronicCompass_T05.brd, ElectronicCompass_T05.sch]
2013-11-15 Made some more updates to the schematic according to what Andrew suggested. Still need to put in the new batter header and then fix the board layout.
    [ElectronicCompass_T05.brd, ElectronicCompass_T05.sch]
2013-11-15 WBS update
    [Work Breakdown Structure.xlsx]
2013-11-15 Made some updates to the schem and board. Still a lot of issues with the board layout that need to be worked out.
    [ElectronicCompass_T05.brd, ElectronicCompass_T05.sch]
2013-11-16 Fixed transistor switches
    [ElectronicCompass_T05.brd, ElectronicCompass_T05.sch]
2013-11-16 LTSpice switch simulation
2013-11-16 sch changes
    [ElectronicCompass_T05.brd, ElectronicCompass_T05.sch]
2013-11-16 New components
    [ElectronicCompass_T05.brd, ElectronicCompass_T05.sch]
2013-11-16 Working LSM393 interface without proper calibration values.
2013-11-16 sch update
    [ElectronicCompass_T05.brd, ElectronicCompass_T05.sch]
2013-11-17 sch and layout changes
    [ElectronicCompass_T05.brd]
2013-11-17 layout done
    [ElectronicCompass_T05.brd]
2013-11-17 layout update
    [ElectronicCompass_T05.brd]
2013-11-18 Fix Git Sync Issue
    [Board_Layout_Checklist.xlsx, ElectronicCompass_T05.brd, ElectronicCompass_T05.sch]
2013-11-18 Adding board layout files
    [Board_Layout_Checklist.xlsx, ElectronicCompass_T05.brd, ElectronicCompass_T05.sch]
2013-11-19 Pin change on LTC4067
2013-11-19 Simulated change to switch
2013-11-19 updated changes to board layout
    [ElectronicCompass_T05.brd, ElectronicCompass_T05.sch]
2013-11-19 Fixed PMIC pins and GPIO switches
    [ElectronicCompass_T05.brd, ElectronicCompass_T05.sch]
2013-11-19 BOM uploaded
2013-11-19 s-screen layout update
    [ElectronicCompass_T05.brd, ElectronicCompass_T05.sch]
2013-11-19 Added the class diagram and stuff
    [Class Diagram.xlsx]
2013-11-20 BOM checklist
2013-11-26 Fixed image arrays= bugs by explicitly loading from flash.
    [PCD8544.cpp, PCD8544.h, main.cpp]
2013-11-26 Initial work on temporary string print function for LCD.
2013-11-27 Test case for PMIC
    [Test Case for PMIC.xlsx]
2013-11-27 Work on Test Plan
    [Test Case for PMIC.xlsx]
2013-11-27 Added test case to test plan
2013-12-03 Created solder mask gerber file.
    [ElectronicCompass_T05.brd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]
2013-12-05 updated BOM
2013-12-13 Working compass without calibration.
2013-12-13 Working compass without calibration
2013-12-13 added finances document
    [Finances.xlsx]
2014-11-09 Removed capacitor
    [ElectronicCompass_T05.brd, ElectronicCompass_T05.sch]
